luysrso/mdb-esp32-cashless/kicad/mdb-slave-esp32s3.kicad_sch

## KiCad design kicad/mdb-slave-esp32s3.kicad_sch (2025-10-05)

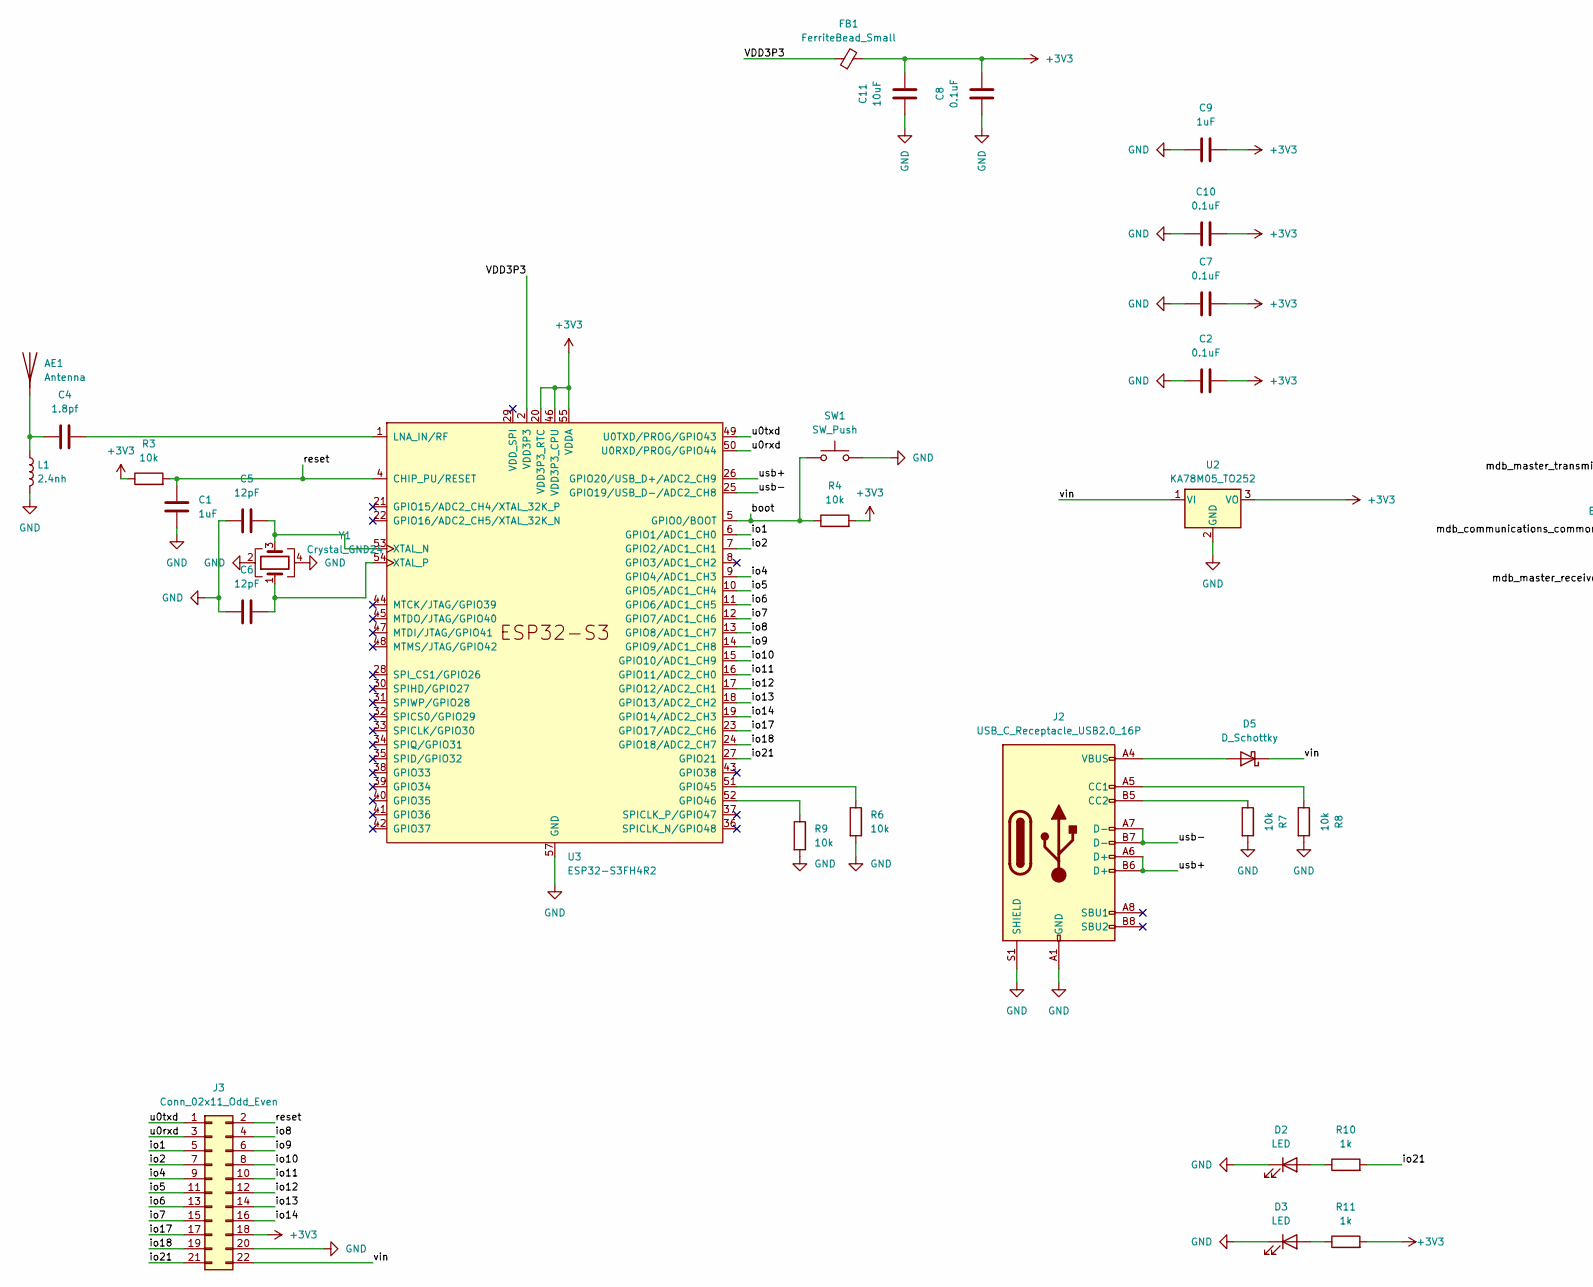
[picture p1: schematic mdb-slave-esp32s3.kicad_sch, part in row 1, column 1]

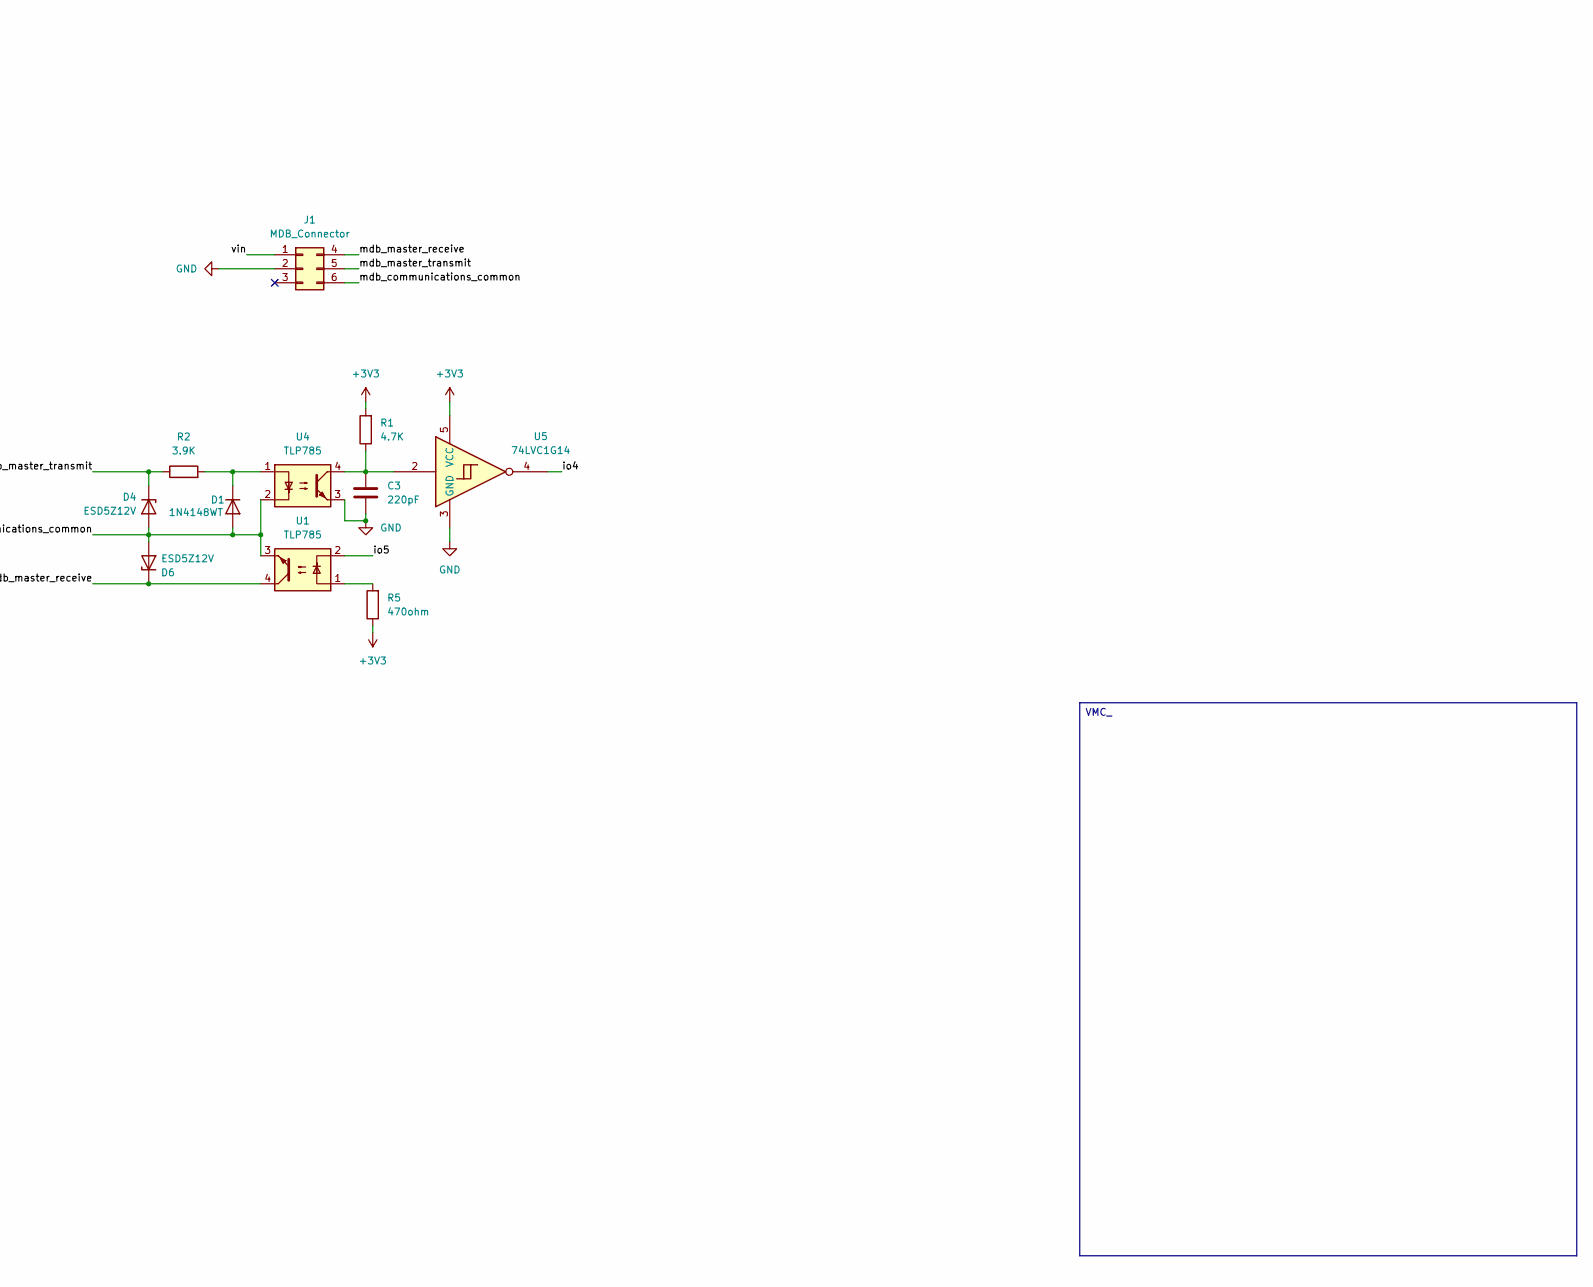
[picture p2: schematic mdb-slave-esp32s3.kicad_sch, part in row 1, column 2]

Parts:
AE1: Antenna; Texas_SWRA117D_2.4GHz_Left
C1, C9: 1uF; C_0603_1608Metric; LCSC# C6119849
C2, C7, C8, C10: 0.1uF; C_0603_1608Metric; LCSC# C5137636
C3: 220pF; C_0603_1608Metric; LCSC# C5137636
C4: 1.8pf; C_0603_1608Metric; LCSC# C376773
C5, C6: 12pF; C_0603_1608Metric; LCSC# C363546
C11: 10uF; C_0603_1608Metric; LCSC# C6119864
D1: 1N4148WT; D_SOD-523
D2, D3: LED; LED_0603_1608Metric; LCSC# C7496820
D4, D6: ESD5Z12V; D_SOD-523
D5: D_Schottky; D_SOD-123; LCSC# C18195164
FB1: FerriteBead_Small; L_0603_1608Metric; LCSC# C304319
J1: MDB_Connector; Molex_Mini-Fit_Jr_5566-06A_2x03_P4.20mm_Vertical; LCSC# C22365701
J2: USB_C_Receptacle_USB2.0_16P; USB_C_Receptacle_G-Switch_GT-USB-7010ASV; LCSC# C2988369
J3: Conn_02x11_Odd_Even; PinHeader_2x11_P2.54mm_Vertical; LCSC# C41375952
L1: 2.4nh; L_0603_1608Metric; LCSC# C2042508
R1: 4.7K; R_0603_1608Metric; LCSC# C98220
R2: 3.9K; R_0603_1608Metric; LCSC# C114669
R3, R4, R6, R7, R8, R9: 10k; R_0603_1608Metric; LCSC# C98220
R5: 470ohm; R_0603_1608Metric; LCSC# C114669
R10, R11: 1k; R_0603_1608Metric; LCSC# C2907113
SW1: SW_Push; SW_Tactile_SPST_NO_Straight_CK_PTS636Sx25SMTRLFS; LCSC# C42435421
U1, U4: TLP785; SMDIP-4_W7.62mm; LCSC# C41383960
U2: KA78M05_TO252; TO-252-2; LCSC# C22395385
U3: ESP32-S3FH4R2; QFN-56-1EP_7x7mm_P0.4mm_EP4x4mm; MOUSER# 356-ESP32-S3FH4R2
U5: 74LVC1G14
Y1: Crystal_GND24; Crystal_SMD_3225-4Pin_3.2x2.5mm; LCSC# C7294599

Connections:
+3V3: C2.2, C7.2, C8.2, C9.2, C10.2, C11.2, FB1.2, J3.18, R1.2, R3.1, R4.2, R5.1, R11.2, U2.3 (VO), U3.20 (VDD3P3_RTC), U3.46 (VDD3P3_CPU), U3.55 (VDDA), U3.56 (VDDA), U5.5 (VCC)
GND: C1.2, C2.1, C3.2, C5.1, C6.1, C7.1, C8.1, C9.1, C10.1, C11.1, D2.1 (K), D3.1 (K), J1.2, J2.A1 (GND), J2.A12 (GND), J2.B1 (GND), J2.B12 (GND), J2.S1 (SHIELD), J3.20, L1.2, R6.2, R7.2, R8.2, R9.2, SW1.2, U2.2 (GND), U3.57 (GND), U4.3, U5.3 (GND), Y1.2, Y1.4
unnamed: AE1.1, C4.1, L1.1
unnamed: C3.1, R1.1, U4.4, U5.2
unnamed: C4.2, U3.1 (LNA_IN/RF)
unnamed: C5.2, U3.53 (XTAL_N), Y1.3
unnamed: C6.2, U3.54 (XTAL_P), Y1.1
unnamed: D1.1 (K), R2.2, U4.1
unnamed: D2.2 (A), R10.1
unnamed: D3.2 (A), R11.1
unnamed: D5.2 (A), J2.A4 (VBUS), J2.A9 (VBUS), J2.B4 (VBUS), J2.B9 (VBUS)
unnamed: J2.A5 (CC1), R8.1
unnamed: J2.B5 (CC2), R7.1
unnamed: R5.2, U1.1
unnamed: R6.1, U3.51 (GPIO45)
unnamed: R9.1, U3.52 (GPIO46)
VDD3P3: FB1.1, U3.2 (VDD3P3), U3.3 (VDD3P3)
boot: R4.1, SW1.1, U3.5 (GPIO0/BOOT)
io1: J3.5, U3.6 (GPIO1/ADC1_CH0)
io2: J3.7, U3.7 (GPIO2/ADC1_CH1)
io4: J3.9, U3.9 (GPIO4/ADC1_CH3), U5.4
io5: J3.11, U1.2, U3.10 (GPIO5/ADC1_CH4)
io6: J3.13, U3.11 (GPIO6/ADC1_CH5)
io7: J3.15, U3.12 (GPIO7/ADC1_CH6)
io8: J3.4, U3.13 (GPIO8/ADC1_CH7)
io9: J3.6, U3.14 (GPIO9/ADC1_CH8)
io10: J3.8, U3.15 (GPIO10/ADC1_CH9)
io11: J3.10, U3.16 (GPIO11/ADC2_CH0)
io12: J3.12, U3.17 (GPIO12/ADC2_CH1)
io13: J3.14, U3.18 (GPIO13/ADC2_CH2)
io14: J3.16, U3.19 (GPIO14/ADC2_CH3)
io17: J3.17, U3.23 (GPIO17/ADC2_CH6)
io18: J3.19, U3.24 (GPIO18/ADC2_CH7)
io21: J3.21, R10.2, U3.27 (GPIO21)
mdb_communications_common: D1.2 (A), D4.2 (A), D6.2 (A), J1.6, U1.3, U4.2
mdb_master_receive: D6.1 (K), J1.4, U1.4
mdb_master_transmit: D4.1 (K), J1.5, R2.1
reset: C1.1, J3.2, R3.2, U3.4 (CHIP_PU/RESET)
u0rxd: J3.3, U3.50 (U0RXD/PROG/GPIO44)
u0txd: J3.1, U3.49 (U0TXD/PROG/GPIO43)
usb+: J2.A6 (D+), J2.B6 (D+), U3.26 (GPIO20/USB_D+/ADC2_CH9)
usb-: J2.A7 (D-), J2.B7 (D-), U3.25 (GPIO19/USB_D-/ADC2_CH8)
vin: D5.1 (K), J1.1, J3.22, U2.1 (VI)

Notes on the sheet:
VMC_
