luysrso/mdb-esp32-cashless/(commit log)

2025-10-05 Update KiCad project and add schematic
    [mdb-slave-esp32s3.kicad_sch]
2025-10-06 Refactor command decoding switch for clarity
    Reorganized the command decoding switch statement in mdb_cashless_loop to use nested switches for subcommands, improving readability and maintainability. No functional changes were made to the command handling logic.
2025-10-07 Update KiCad project files and improve vend cancel logic
    Modified KiCad project files to adjust visible items, layer settings, and net class priorities. In mdb-slave-esp32s3.c, improved vend cancel handling by resetting vend approval/denial flags and updating machine state when canceling a vend.
    [mdb-slave-esp32s3.c]
